wildsystems-private-team/HA_Addons/HVAC/UnderfloorHeating/UnderfloorHeatingActuatorsControl/220V/uhc-12/Images/uhc-12.png

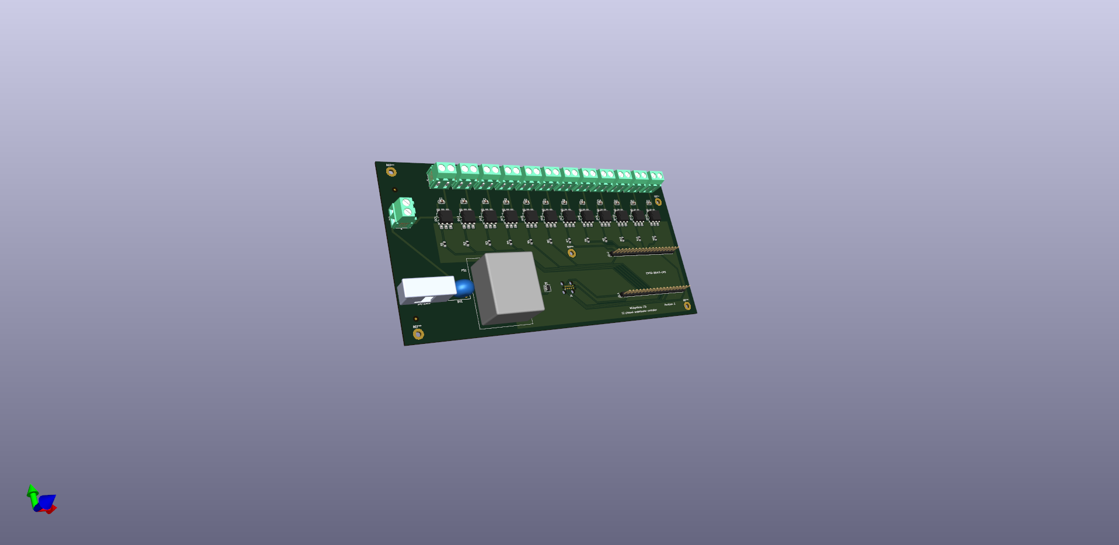
HVAC/UnderfloorHeating/UnderfloorHeatingActuatorsControl/220V/uhc-12/Images/uhc-12.png
