wildsystems-private-team/HA_Addons/HVAC/UnderfloorHeating/UnderfloorHeatingActuatorsControl/220V/uhc-12/Images/uhc-12-case.PNG

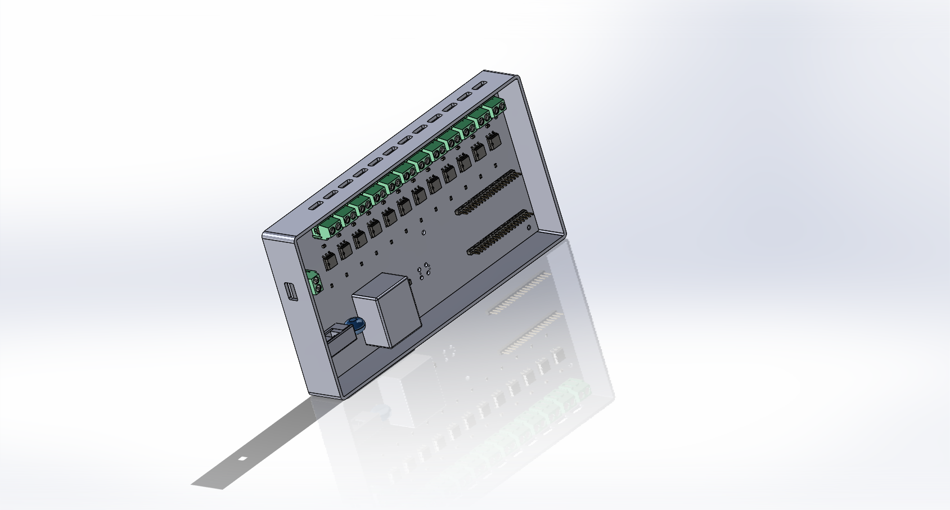
HVAC/UnderfloorHeating/UnderfloorHeatingActuatorsControl/220V/uhc-12/Images/uhc-12-case.PNG
