wildsystems-private-team/HA_Addons/HVAC/UnderfloorHeating/UnderfloorHeatingActuatorsControl/220V/uhc-12/v1/board-2.jpg

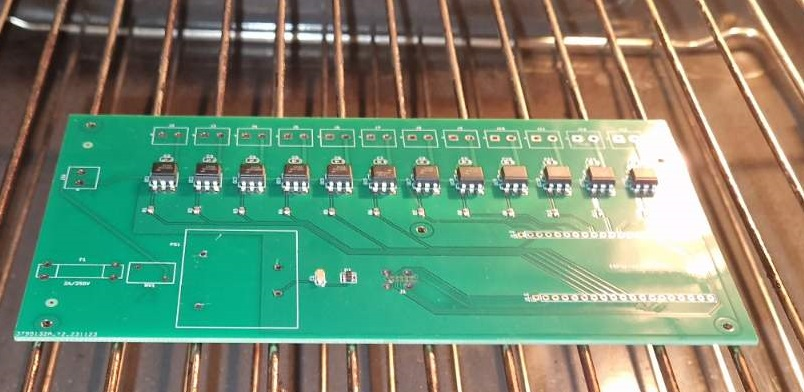
HVAC/UnderfloorHeating/UnderfloorHeatingActuatorsControl/220V/uhc-12/v1/board-2.jpg
