wildsystems-private-team/HA_Addons/HVAC/UnderfloorHeating/UnderfloorHeatingActuatorsControl/220V/uhc-12/case/CaseBottom.SLDPRT

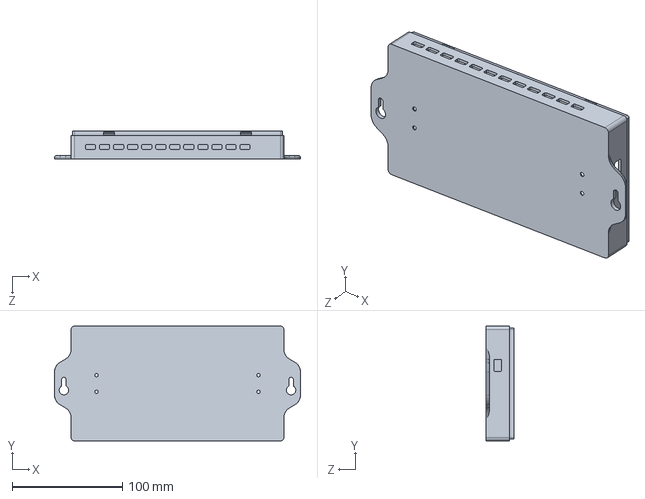
[picture p7: CAD file, 2023-12-01]
HVAC/UnderfloorHeating/UnderfloorHeatingActuatorsControl/220V/uhc-12/case/CaseBottom.SLDPRT
222.7 x 103.8 x 25.0 mm
