wildsystems-private-team/HA_Addons/HVAC/UnderfloorHeating/UnderfloorHeatingActuatorsControl/220V/uhc-12/case/CaseTop.SLDPRT

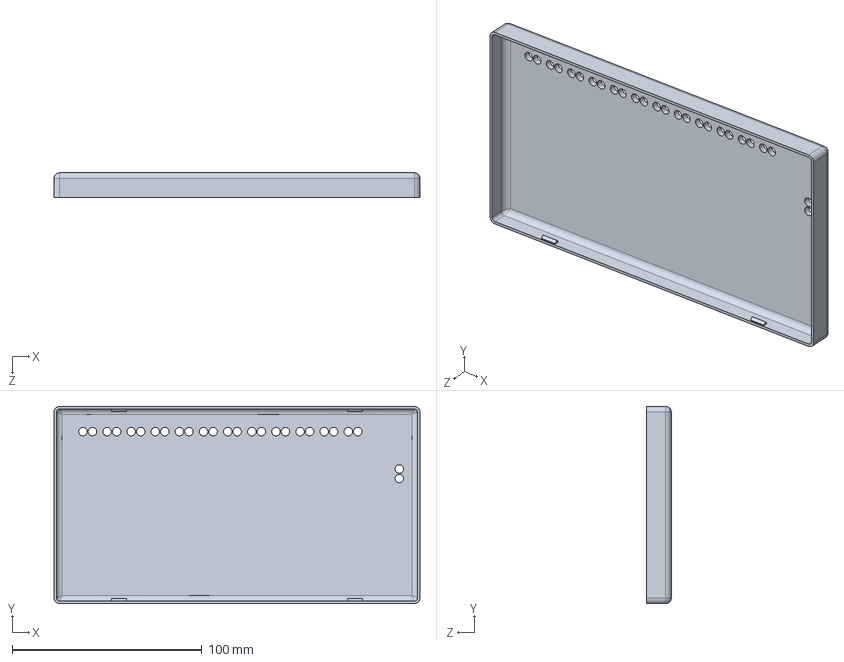
[picture p8: CAD file, 2023-11-30]
HVAC/UnderfloorHeating/UnderfloorHeatingActuatorsControl/220V/uhc-12/case/CaseTop.SLDPRT
192.7 x 103.8 x 13.0 mm
