wildsystems-private-team/HA_Addons/HVAC/UnderfloorHeating/UnderfloorHeatingActuatorsControl/24v/uhc-24-8/hardware/PCB/case/Lid.SLDPRT

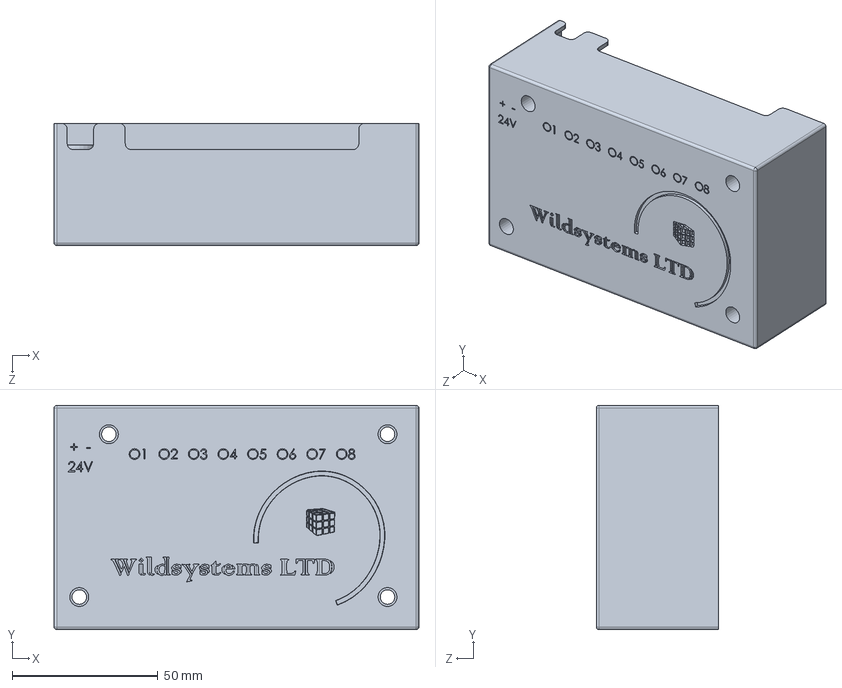
[picture p9: CAD file, 2024-10-05]
HVAC/UnderfloorHeating/UnderfloorHeatingActuatorsControl/24v/uhc-24-8/hardware/PCB/case/Lid.SLDPRT
125.3 x 77.0 x 42.0 mm
