wildsystems-private-team/HA_Addons/HVAC/UnderfloorHeating/UnderfloorHeatingActuatorsControl/24v/uhc-24-8/hardware/PCB/case/Case.SLDPRT

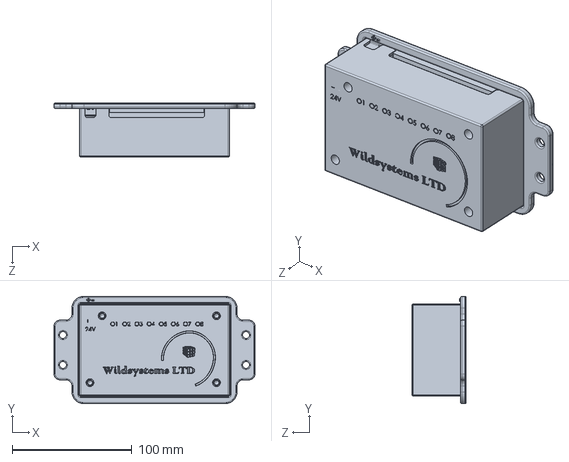
[picture p10: CAD file, 2024-10-05]
HVAC/UnderfloorHeating/UnderfloorHeatingActuatorsControl/24v/uhc-24-8/hardware/PCB/case/Case.SLDPRT
168.1 x 89.9 x 45.2 mm
