wildsystems-private-team/HA_Addons/HVAC/UnderfloorHeating/UnderfloorHeatingActuatorsControl/220V/uhc-12/case/uhc-12.SLDASM

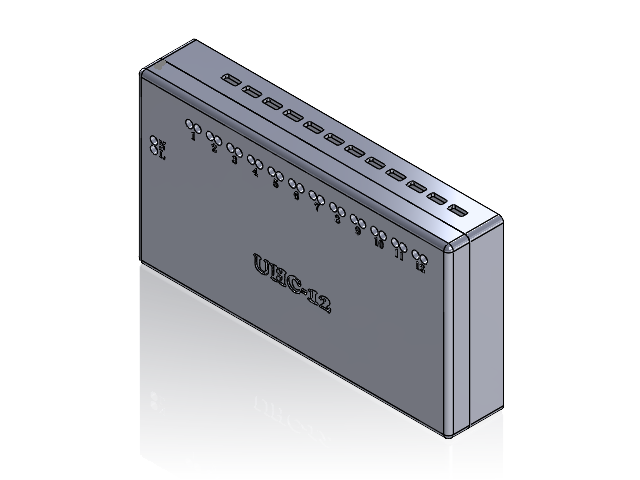
[picture p12: CAD file, 2023-11-30]
HVAC/UnderfloorHeating/UnderfloorHeatingActuatorsControl/220V/uhc-12/case/uhc-12.SLDASM
uhc-12 PCB
Case_bottom
