wildsystems-private-team/HA_Addons/HVAC/UnderfloorHeating/UnderfloorHeatingActuatorsControl/24v/uhc-24-8/hardware/PCB/case/uhc-24-8.SLDASM

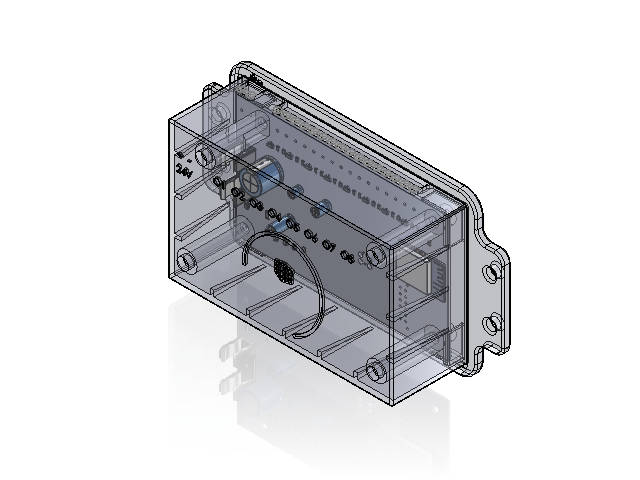
[picture p13: CAD file, 2024-10-05]
HVAC/UnderfloorHeating/UnderfloorHeatingActuatorsControl/24v/uhc-24-8/hardware/PCB/case/uhc-24-8.SLDASM
C_Radial_D50mm_H110mm_P200mm
C_0805_2012Metric-0 x 2
R_0805_2012Metric-1 x 18
SOT_23 x 8
TSOT_23_5
CP_Radial_D125mm_P500mm
D_SOD_323
L_0805_2012Metric-2
A_Schurter_0031_8201
C_Radial_D40mm_H70mm_P150mm
C_Radial_D40mm_H50mm_P150mm
R_1206_3216Metric-3
ESP32-WROOM-32-4
D_SOD_123
_autosave-uhc-24-8 PCB
Case
