wildsystems-private-team/HA_Addons/(list of files, cad)

Other CAD files:
HVAC/UnderfloorHeating/UnderfloorHeatingActuatorsControl/24v/uhc-24-8/hardware/PCB/case/TSOT-23-5.SLDASM
HVAC/UnderfloorHeating/UnderfloorHeatingActuatorsControl/220V/uhc-12/case/Fuse holder.SLDASM
HVAC/UnderfloorHeating/UnderfloorHeatingActuatorsControl/24v/uhc-24-8/hardware/PCB/case/C_Radial_D4.0mm_H5.0mm_P1.50mm.SLDASM
HVAC/UnderfloorHeating/UnderfloorHeatingActuatorsControl/220V/uhc-12/case/DG500-5.0-02P-14-00AH.SLDASM
HVAC/UnderfloorHeating/UnderfloorHeatingActuatorsControl/220V/uhc-12/case/ZP05SXX00WB.SLDASM
HVAC/UnderfloorHeating/UnderfloorHeatingActuatorsControl/24v/uhc-24-8/hardware/PCB/case/L_0805_2012Metric.SLDASM
HVAC/UnderfloorHeating/UnderfloorHeatingActuatorsControl/24v/uhc-24-8/hardware/PCB/case/R_1206_3216Metric.SLDASM
HVAC/UnderfloorHeating/UnderfloorHeatingActuatorsControl/24v/uhc-24-8/hardware/PCB/case/C_Radial_D4.0mm_H7.0mm_P1.50mm.SLDASM
HVAC/UnderfloorHeating/UnderfloorHeatingActuatorsControl/24v/uhc-24-8/hardware/PCB/case/CP_Radial_D12.5mm_P5.00mm.SLDASM
HVAC/UnderfloorHeating/UnderfloorHeatingActuatorsControl/24v/uhc-24-8/hardware/PCB/case/ESP32-WROOM-32.SLDASM
HVAC/UnderfloorHeating/UnderfloorHeatingActuatorsControl/24v/uhc-24-8/hardware/PCB/case/Fuseholder_Cylinder-5x20mm_Schurter_0031_8201_Horizontal_Open.SLDASM
HVAC/UnderfloorHeating/UnderfloorHeatingActuatorsControl/24v/uhc-24-8/hardware/PCB/case/SOT-23.SLDASM
HVAC/UnderfloorHeating/UnderfloorHeatingActuatorsControl/24v/uhc-24-8/hardware/PCB/case/D_SOD-323.SLDASM
HVAC/UnderfloorHeating/UnderfloorHeatingActuatorsControl/24v/uhc-24-8/hardware/PCB/case/C_0805_2012Metric.SLDASM
HVAC/UnderfloorHeating/UnderfloorHeatingActuatorsControl/24v/uhc-24-8/hardware/PCB/case/D_SOD-123.SLDASM
HVAC/UnderfloorHeating/UnderfloorHeatingActuatorsControl/24v/uhc-24-8/hardware/PCB/case/C_Radial_D5.0mm_H11.0mm_P2.00mm.SLDASM
HVAC/UnderfloorHeating/UnderfloorHeatingActuatorsControl/24v/uhc-24-8/hardware/PCB/case/R_0805_2012Metric.SLDASM
HVAC/UnderfloorHeating/UnderfloorHeatingActuatorsControl/24v/uhc-24-8/hardware/PCB/case/CP_Radial_D125mm_P500mm.SLDPRT
HVAC/UnderfloorHeating/UnderfloorHeatingActuatorsControl/24v/uhc-24-8/hardware/PCB/case/R_0805_2012Metric-1.SLDPRT
HVAC/UnderfloorHeating/UnderfloorHeatingActuatorsControl/24v/uhc-24-8/hardware/PCB/case/C_Radial_D40mm_H70mm_P150mm.SLDPRT
HVAC/UnderfloorHeating/UnderfloorHeatingActuatorsControl/220V/uhc-12/case/SOLID-6.SLDPRT
HVAC/UnderfloorHeating/UnderfloorHeatingActuatorsControl/220V/uhc-12/case/uhc-12 PCB.SLDPRT
HVAC/UnderfloorHeating/UnderfloorHeatingActuatorsControl/24v/uhc-24-8/hardware/PCB/case/R_1206_3216Metric-3.SLDPRT
HVAC/UnderfloorHeating/UnderfloorHeatingActuatorsControl/220V/uhc-12/case/COMPOUND.SLDPRT
HVAC/UnderfloorHeating/UnderfloorHeatingActuatorsControl/220V/uhc-12/case/SOLID-7.SLDPRT
HVAC/UnderfloorHeating/UnderfloorHeatingActuatorsControl/24v/uhc-24-8/hardware/PCB/case/A_Schurter_0031_8201.SLDPRT
HVAC/UnderfloorHeating/UnderfloorHeatingActuatorsControl/24v/uhc-24-8/hardware/PCB/case/C_Radial_D40mm_H50mm_P150mm.SLDPRT
HVAC/UnderfloorHeating/UnderfloorHeatingActuatorsControl/24v/uhc-24-8/hardware/PCB/case/L_0805_2012Metric-2.SLDPRT
HVAC/UnderfloorHeating/UnderfloorHeatingActuatorsControl/24v/uhc-24-8/hardware/PCB/case/C_0805_2012Metric-0.SLDPRT
HVAC/UnderfloorHeating/UnderfloorHeatingActuatorsControl/24v/uhc-24-8/hardware/PCB/case/ESP32-WROOM-32-4.SLDPRT
HVAC/UnderfloorHeating/UnderfloorHeatingActuatorsControl/24v/uhc-24-8/hardware/PCB/case/C_Radial_D50mm_H110mm_P200mm.SLDPRT
HVAC/UnderfloorHeating/UnderfloorHeatingActuatorsControl/220V/uhc-12/case/CaseBottom.3MF
HVAC/UnderfloorHeating/UnderfloorHeatingActuatorsControl/220V/uhc-12/case/CaseTop.3MF
HVAC/UnderfloorHeating/UnderfloorHeatingActuatorsControl/220V/uhc-12/case/Case_bottom.SLDPRT
HVAC/UnderfloorHeating/UnderfloorHeatingActuatorsControl/24v/uhc-24-8/hardware/PCB/case/Body.3MF
HVAC/UnderfloorHeating/UnderfloorHeatingActuatorsControl/24v/uhc-24-8/hardware/PCB/case/D_SOD_123.SLDPRT
HVAC/UnderfloorHeating/UnderfloorHeatingActuatorsControl/24v/uhc-24-8/hardware/PCB/case/D_SOD_323.SLDPRT
HVAC/UnderfloorHeating/UnderfloorHeatingActuatorsControl/24v/uhc-24-8/hardware/PCB/case/Lid.3MF
HVAC/UnderfloorHeating/UnderfloorHeatingActuatorsControl/24v/uhc-24-8/hardware/PCB/case/SOT_23.SLDPRT
HVAC/UnderfloorHeating/UnderfloorHeatingActuatorsControl/24v/uhc-24-8/hardware/PCB/case/TSOT_23_5.SLDPRT
