wildsystems-private-team/HA_Addons/HVAC/UnderfloorHeating/UnderfloorHeatingActuatorsControl/24v/uhc-24-8/hardware/PCB/uhc-24-8.kicad_pcb

## KiCad design HVAC/UnderfloorHeating/UnderfloorHeatingActuatorsControl/24v/uhc-24-8/hardware/PCB/uhc-24-8.kicad_pcb (2024-10-24)

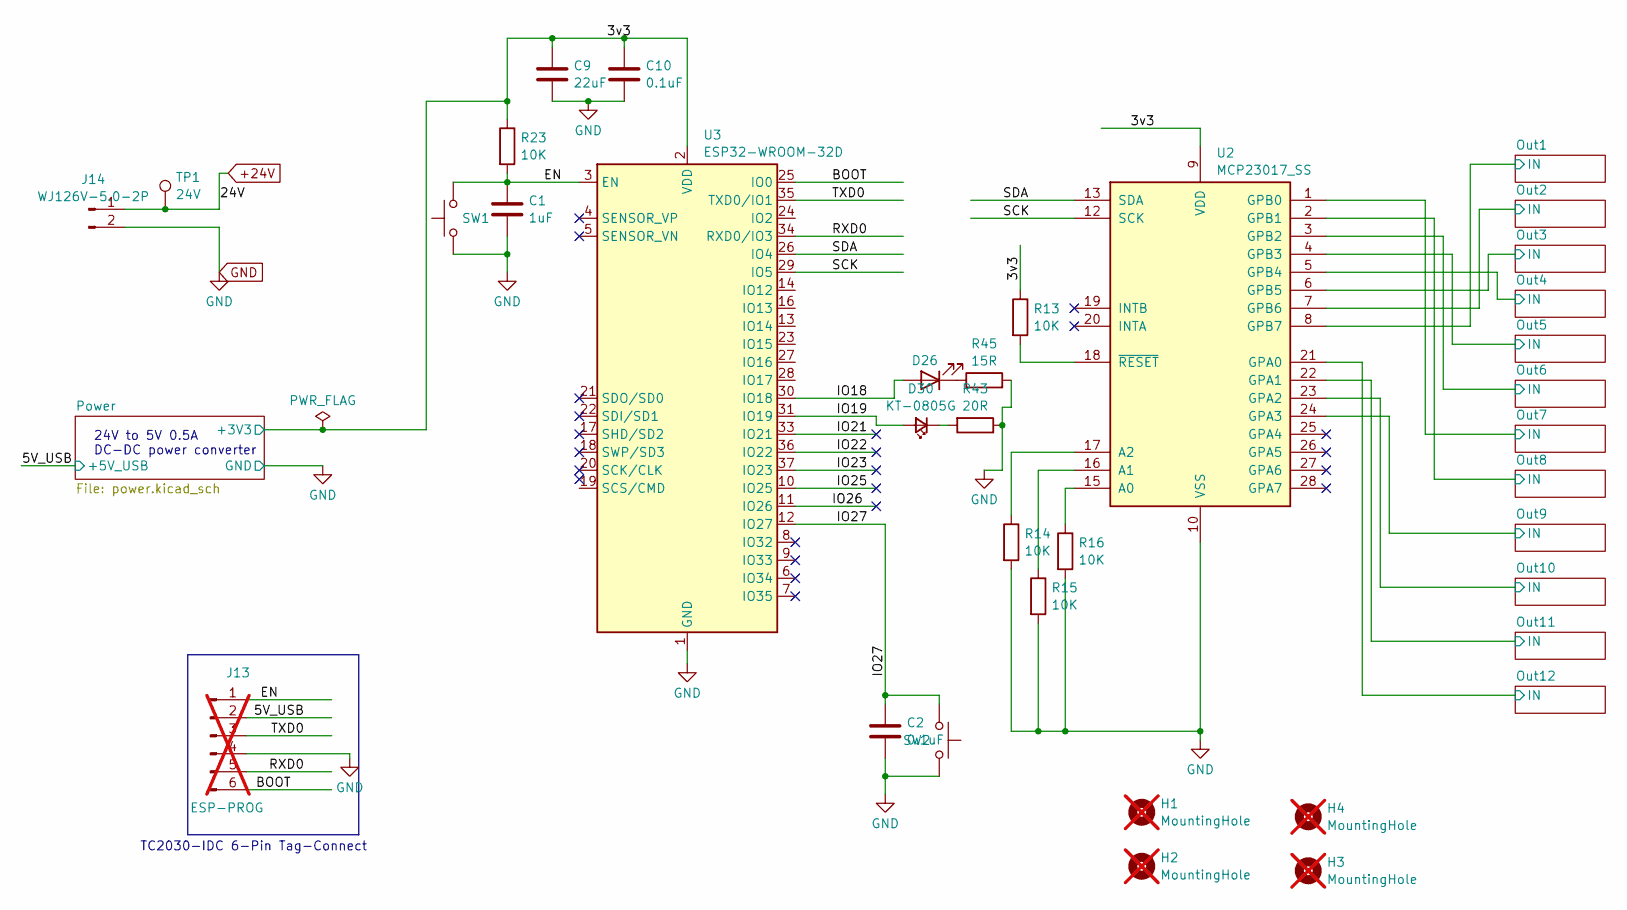
[picture p14: schematic uhc-24-8.kicad_sch]

Parts:
C1: 1uF; C_0402_1005Metric; LCSC Part # C14445
C2, C10: 0.1uF; C_0402_1005Metric; LCSC Part # C541406
C9: 22uF; C_0603_1608Metric; LCSC Part # C59461
D26: KT-0805B; D_0805_2012Metric; LCSC Part # C2293
D30: KT-0805G; LED_0805_2012Metric; LCSC Part # C2297
H1, H2, H3, H4: MountingHole; MountingHole_3.2mm_M3; not fitted
J13: ESP-PROG; Tag-Connect_TC2030-IDC-FP_2x03_P1.27mm_Vertical; not fitted
J14: WJ126V-5.0-2P; CONN-TH_2P-P5.08_DIBO_DB142V-5.08-2P; LCSC Part # C2898699
R13, R14, R15, R16, R23: 10K; R_0603_1608Metric; LCSC Part # C25804
R43: 20R; R_0805_2012Metric; LCSC Part # C17659
R45: 15R; R_0805_2012Metric
SW1: Reboot; SW-SMD_4P-L5.1-W5.1-P3.70-LS6.5-TL-2; LCSC Part # C318884
SW2: Clear; SW-SMD_4P-L5.1-W5.1-P3.70-LS6.5-TL-2; LCSC Part # C318884
TP1: 24V; TestPoint_Pad_D2.0mm
U2: MCP23017_SS; SSOP-28_5.3x10.2mm_P0.65mm; LCSC Part # C558584
U3: ESP32-WROOM-32D; WIFI-SMD_ESP32-WROOM-32E-A; LCSC Part # C701341

Connections:
+24V: J14.1, TP1.1; also elsewhere on the board
/3v3: C9.1, C10.1, R13.1, R23.1, U2.9 (VDD), U3.2 (VDD); also elsewhere on the board
/5V_USB: J13.2; also elsewhere on the board
/BOOT: J13.6, U3.25 (IO0)
/EN: C1.1, J13.1, R23.2, SW1.2, U3.3 (EN)
/IO18: D26.2 (A), U3.30 (IO18)
/IO19: D30.2 (A), U3.31 (IO19)
/IO21: U3.33 (IO21)
/IO22: U3.36 (IO22)
/IO23: U3.37 (IO23)
/IO25: U3.10 (IO25)
/IO26: U3.11 (IO26)
/IO27: C2.1, SW2.2, U3.12 (IO27)
/Out1/IN: U2.8 (GPB7); also elsewhere on the board
/Out2/IN: U2.7 (GPB6); also elsewhere on the board
/Out3/IN: U2.6 (GPB5); also elsewhere on the board
/Out4/IN: U2.5 (GPB4); also elsewhere on the board
/Out5/IN: U2.4 (GPB3); also elsewhere on the board
/Out6/IN: U2.3 (GPB2); also elsewhere on the board
/Out7/IN: U2.1 (GPB0); also elsewhere on the board
/Out8/IN: U2.2 (GPB1); also elsewhere on the board
/Out9/IN: U2.24 (GPA3); also elsewhere on the board
/Out10/IN: U2.23 (GPA2); also elsewhere on the board
/Out11/IN: U2.22 (GPA1); also elsewhere on the board
/Out12/IN: U2.21 (GPA0); also elsewhere on the board
/RXD0: J13.5, U3.34 (RXD0/IO3)
/SCK: U2.12 (SCK), U3.29 (IO5)
/SDA: U2.13 (SDA), U3.26 (IO4)
/TXD0: J13.3, U3.35 (TXD0/IO1)
GND: C1.2, C2.2, C9.2, C10.2, J13.4, J14.2, R14.2, R15.2, R16.2, R43.1, R45.2, SW1.1, SW2.1, U2.10 (VSS), U3.1 (GND), U3.15 (GND), U3.38 (GND), U3.39 (GND); also elsewhere on the board
unnamed: D26.1 (K), R45.1
unnamed: D30.1 (K), R43.2
unnamed: R16.1, U2.15 (A0)
unnamed: R15.1, U2.16 (A1)
unnamed: R14.1, U2.17 (A2)
unnamed: R13.2, U2.18 (~RESET)

Notes on the sheet:
24V to 5V 0.5A DC-DC power converter
TC2030-IDC 6-Pin Tag-Connect

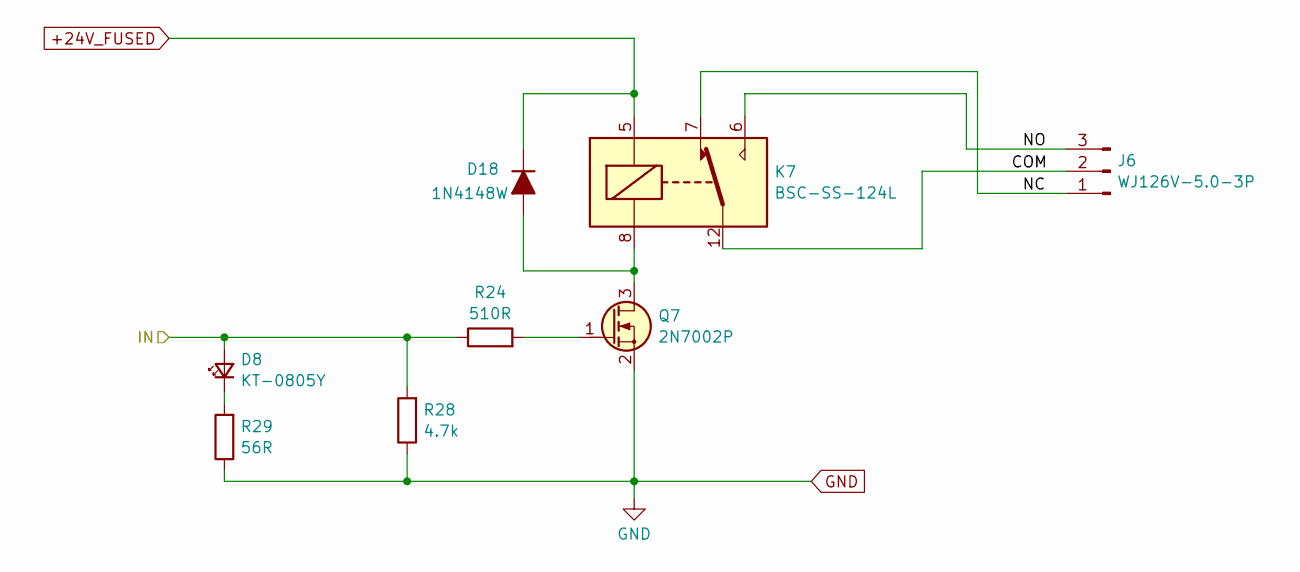
[picture p15: schematic outputs.kicad_sch]

Parts:
D8: KT-0805Y; LED_0805_2012Metric; LCSC Part # C2296
D18: 1N4148W; D_SOD-123; LCSC Part # C81598
J6: WJ126V-5.0-3P; CONN-TH_3P-P5.08_DIBO_DB142V-5.08-3P; LCSC Part # C2898700
K7: BSC-SS-124L; Relay_SPDT_QLRELAY_BSC; LCSC Part # C22384984
Q7: 2N7002P; SOT-23; LCSC Part # C81488
R24: 510R; R_0805_2012Metric; LCSC Part # C17734
R28: 4.7k; R_0805_2012Metric; LCSC Part # C17673
R29: 56R; R_0805_2012Metric; LCSC Part # C17757

Connections:
+24V_FUSED: D18.1 (K), K7.5; also elsewhere on the board
/Out7/COM: J6.2, K7.12
/Out7/IN: D8.2 (A), R24.1, R28.2; also elsewhere on the board
/Out7/NC: J6.1, K7.7
/Out7/NO: J6.3, K7.6
GND: Q7.2 (S), R28.1, R29.1; also elsewhere on the board
unnamed: D8.1 (K), R29.2
unnamed: D18.2 (A), K7.8, Q7.3 (D)
unnamed: Q7.1 (G), R24.2

Parts of its further copies:
D1, D2, D3, D4, D5, D6, D7, D9, D10, D11, D12: KT-0805Y; LED_0805_2012Metric; LCSC Part # C2296
D13, D14, D15, D16, D17, D19, D20, D21, D22, D23, D24: 1N4148W; D_SOD-123; LCSC Part # C81598
J1, J2, J3, J4, J5, J7, J8, J9, J10, J11, J12: WJ126V-5.0-3P; CONN-TH_3P-P5.08_DIBO_DB142V-5.08-3P; LCSC Part # C2898700
K1, K2, K3, K4, K5, K6, K8, K9, K10, K11, K12: BSC-SS-124L; Relay_SPDT_QLRELAY_BSC; LCSC Part # C22384984
Q1, Q2, Q3, Q4, Q5, Q6, Q8, Q9, Q10, Q11, Q12: 2N7002P; SOT-23; LCSC Part # C81488
R1, R6, R7, R11, R17, R20, R26, R30, R34, R36, R41: 510R; R_0805_2012Metric; LCSC Part # C17734
R2, R3, R8, R12, R19, R22, R25, R32, R35, R38, R40: 56R; R_0805_2012Metric; LCSC Part # C17757
R4, R5, R9, R10, R18, R21, R27, R31, R33, R37, R39: 4.7k; R_0805_2012Metric; LCSC Part # C17673

Connections of its further copies:
+24V_FUSED: D13.1 (K), D14.1 (K), D15.1 (K), D16.1 (K), D17.1 (K), D19.1 (K), D20.1 (K), D21.1 (K), D22.1 (K), D23.1 (K), D24.1 (K), K1.5, K2.5, K3.5, K4.5, K5.5, K6.5, K8.5, K9.5, K10.5, K11.5, K12.5; also elsewhere on the board
/Out1/COM: J1.2, K1.12
/Out1/IN: D1.2 (A), R1.1, R5.2; also elsewhere on the board
/Out1/NC: J1.1, K1.7
/Out1/NO: J1.3, K1.6
/Out2/COM: J3.2, K2.12
/Out2/IN: D2.2 (A), R4.2, R6.1; also elsewhere on the board
/Out2/NC: J3.1, K2.7
/Out2/NO: J3.3, K2.6
/Out3/COM: J2.2, K3.12
/Out3/IN: D3.2 (A), R7.1, R9.2; also elsewhere on the board
/Out3/NC: J2.1, K3.7
/Out3/NO: J2.3, K3.6
/Out4/COM: J4.2, K4.12
/Out4/IN: D4.2 (A), R11.1, R18.2; also elsewhere on the board
/Out4/NC: J4.1, K4.7
/Out4/NO: J4.3, K4.6
/Out5/COM: J5.2, K5.12
/Out5/IN: D5.2 (A), R10.2, R17.1; also elsewhere on the board
/Out5/NC: J5.1, K5.7
/Out5/NO: J5.3, K5.6
/Out6/COM: J7.2, K6.12
/Out6/IN: D6.2 (A), R20.1, R21.2; also elsewhere on the board
/Out6/NC: J7.1, K6.7
/Out6/NO: J7.3, K6.6
/Out8/COM: J8.2, K8.12
/Out8/IN: D7.2 (A), R26.1, R27.2; also elsewhere on the board
/Out8/NC: J8.1, K8.7
/Out8/NO: J8.3, K8.6
/Out9/COM: J9.2, K9.12
/Out9/IN: D9.2 (A), R30.1, R31.2; also elsewhere on the board
/Out9/NC: J9.1, K9.7
/Out9/NO: J9.3, K9.6
/Out10/COM: J10.2, K10.12
/Out10/IN: D11.2 (A), R33.2, R36.1; also elsewhere on the board
/Out10/NC: J10.1, K10.7
/Out10/NO: J10.3, K10.6
/Out11/COM: J11.2, K11.12
/Out11/IN: D10.2 (A), R34.1, R37.2; also elsewhere on the board
/Out11/NC: J11.1, K11.7
/Out11/NO: J11.3, K11.6
/Out12/COM: J12.2, K12.12
/Out12/IN: D12.2 (A), R39.2, R41.1; also elsewhere on the board
/Out12/NC: J12.1, K12.7
/Out12/NO: J12.3, K12.6
GND: Q1.2 (S), Q2.2 (S), Q3.2 (S), Q4.2 (S), Q5.2 (S), Q6.2 (S), Q8.2 (S), Q9.2 (S), Q10.2 (S), Q11.2 (S), Q12.2 (S), R2.1, R3.1, R4.1, R5.1, R8.1, R9.1, R10.1, R12.1, R18.1, R19.1, R21.1, R22.1, R25.1, R27.1, R31.1, R32.1, R33.1, R35.1, R37.1, R38.1, R39.1, R40.1; also elsewhere on the board
unnamed: D1.1 (K), R2.2
unnamed: D2.1 (K), R3.2
unnamed: D3.1 (K), R8.2
unnamed: D4.1 (K), R19.2
unnamed: D5.1 (K), R12.2
unnamed: D6.1 (K), R22.2
unnamed: D7.1 (K), R25.2
unnamed: D9.1 (K), R32.2
unnamed: D10.1 (K), R35.2
unnamed: D11.1 (K), R38.2
unnamed: D12.1 (K), R40.2
unnamed: D13.2 (A), K1.8, Q1.3 (D)
unnamed: D14.2 (A), K2.8, Q2.3 (D)
unnamed: D15.2 (A), K3.8, Q3.3 (D)
unnamed: D16.2 (A), K4.8, Q4.3 (D)
unnamed: D17.2 (A), K5.8, Q5.3 (D)
unnamed: D19.2 (A), K6.8, Q6.3 (D)
unnamed: D20.2 (A), K8.8, Q9.3 (D)
unnamed: D21.2 (A), K9.8, Q8.3 (D)
unnamed: D22.2 (A), K10.8, Q10.3 (D)
unnamed: D23.2 (A), K11.8, Q12.3 (D)
unnamed: D24.2 (A), K12.8, Q11.3 (D)
unnamed: Q1.1 (G), R1.2
unnamed: Q2.1 (G), R6.2
unnamed: Q3.1 (G), R7.2
unnamed: Q4.1 (G), R11.2
unnamed: Q5.1 (G), R17.2
unnamed: Q6.1 (G), R20.2
unnamed: Q8.1 (G), R30.2
unnamed: Q9.1 (G), R26.2
unnamed: Q10.1 (G), R36.2
unnamed: Q11.1 (G), R41.2
unnamed: Q12.1 (G), R34.2

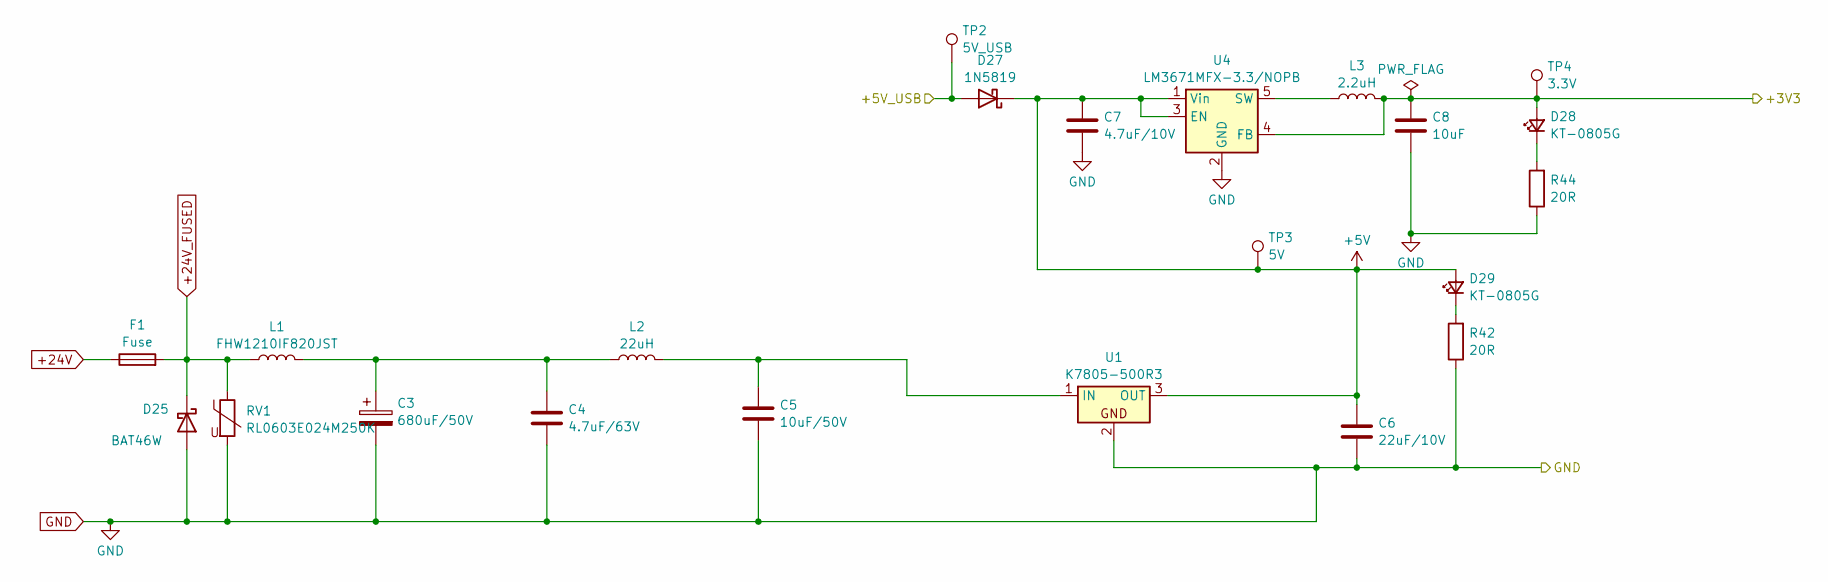
[picture p16: schematic power.kicad_sch]

Parts:
C3: 680uF/50V; CAP-SMD_BD12.5-L13.0-W13.0-LS14.4-FD; LCSC Part # C487372
C4: 4.7uF/63V; C_1206_3216Metric; LCSC Part # C29823
C5: 10uF/50V; C_1206_3216Metric; LCSC Part # C13585
C6: 22uF/10V; C_1206_3216Metric; LCSC Part # C5672
C7: 4.7uF/10V; C_0402_1005Metric; LCSC Part # C23733
C8: 10uF; C_0603_1608Metric; LCSC Part # C19702
D25: BAT46W; D_SOD-123; LCSC Part # C7420332
D27: 1N5819; D_SOD-123; JLCPCB Part # C3033976
D28, D29: KT-0805G; LED_0805_2012Metric; LCSC Part # C2297
F1: Fuse; FUSE-TH_L24.4-W9.4-P22.60; LCSC Part # C717030
L1: FHW1210IF820JST; L_1210_3225Metric; LCSC Part # C394099
L2: 22uH; L_0603_1608Metric; LCSC Part # C6808015
L3: 2.2uH; Ferrite_1206_3216Metric; LCSC Part # C139249
R42, R44: 20R; R_0805_2012Metric; LCSC Part # C17659
RV1: RL0603E024M250K; D_0603_1608Metric; LCSC Part # LCSC Part #
TP2: 5V_USB; TestPoint_Pad_D2.0mm
TP3: 5V; TestPoint_Pad_D2.0mm
TP4: 3.3V; TestPoint_Pad_D2.0mm
U1: K7805-500R3; PWRM-TH_K78XX-500R3; LCSC Part # C909662
U4: LM3671MFX-3.3/NOPB; TSOT-23-5; LCSC Part # C477918

Connections:
+5V: C6.1, C7.1, D27.1 (K), D29.2 (A), TP3.1, U1.3 (OUT), U4.1 (Vin), U4.3 (EN)
+24V: F1.1; also elsewhere on the board
+24V_FUSED: D25.1 (K), F1.2, L1.1, RV1.1; also elsewhere on the board
/3v3: C8.1, D28.2 (A), L3.2, TP4.1, U4.4 (FB); also elsewhere on the board
/5V_USB: D27.2 (A), TP2.1; also elsewhere on the board
GND: C3.2, C4.2, C5.2, C6.2, C7.2, C8.2, D25.2 (A), R42.1, R44.1, RV1.2, U1.2, U4.2 (GND); also elsewhere on the board
unnamed: C3.1, C4.1, L1.2, L2.1
unnamed: D28.1 (K), R44.2
unnamed: D29.1 (K), R42.2
unnamed: C5.1, L2.2, U1.1 (IN)
unnamed: L3.1, U4.5 (SW)

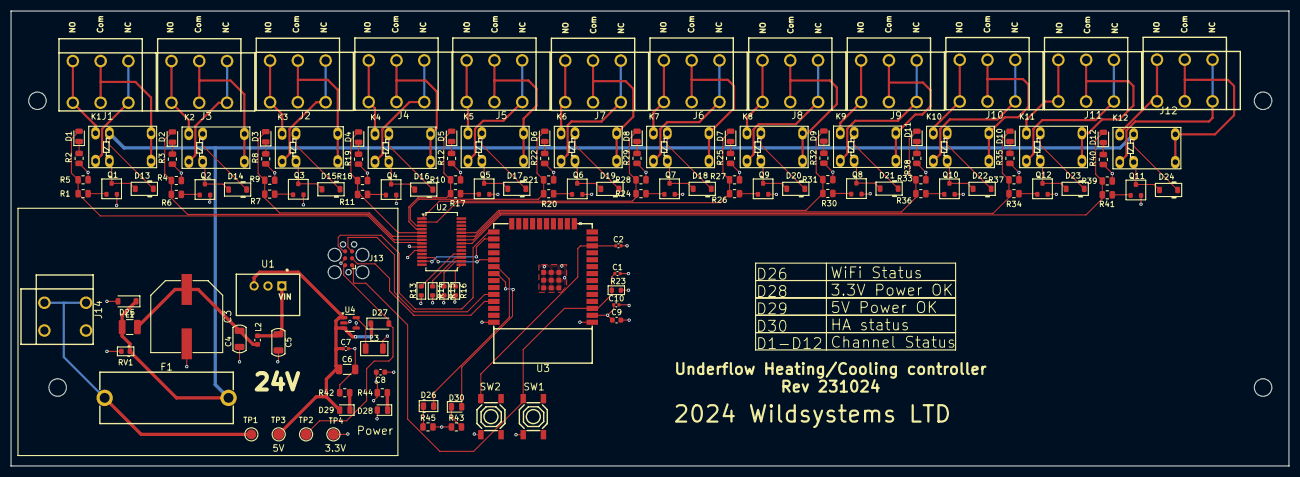
[picture p17: board uhc-24-8.kicad_pcb from above]

Board: 4 copper layers, 233.7 x 83.2 mm, 142 parts (0 on the bottom side), 110 nets.
