wildsystems-private-team/HA_Addons/(commit log)

2023-11-26 Added variables for NPT sensors
2023-11-29 addded ichill NTP sensors
2023-11-30 Added version with 4 outputs
    [Placement.xlsx, power.kicad_sch, power_out.kicad_sch, uhc-4.kicad_pcb, uhc-4.kicad_sch, uhc-4.sch]
2023-11-30 Case for the board
    [CaseBottom.3MF, CaseBottom.SLDPRT, CaseTop.3MF, CaseTop.SLDPRT, Case_bottom.SLDPRT, io220v.kicad_sch, uhc-12.SLDASM, uhc-12.kicad_sch]
2023-12-01 Modified case
    [CaseBottom.SLDPRT]
2023-12-13 corrected typo in names
    [dixell-ic100cx-interface.yaml]
2024-02-21 24V 8 cahnnel underfloor heating controler addedd
    [block_diagram.kicad_sch, outputs.kicad_sch, power.kicad_sch, uhc-24-4.sch, uhc-24-8.kicad_pcb, uhc-24-8.kicad_sch]
2024-03-06 For review
    [outputs.kicad_sch, power.kicad_sch, uhc-24-8.kicad_pcb, uhc-24-8.kicad_sch]
2024-10-05 Folder reorganization
    [A_Schurter_0031_8201.SLDPRT, Body.3MF, Body.SLDPRT, CP_Radial_D12.5mm_P5.00mm.SLDASM, CP_Radial_D125mm_P500mm.SLDPRT, C_0805_2012Metric-0.SLDPRT, C_0805_2012Metric.SLDASM, C_Radial_D4.0mm_H5.0mm_P1.50mm.SLDASM]
2024-10-24 Ready for fabrication
    [outputs.kicad_sch, power.kicad_sch, uhc-24-8.kicad_pcb, uhc-24-8.kicad_sch]
